nikolasibalic/ZSAR-Zeeman-Shifted-Atomic-Reference/parts/technical_drawings.PDF

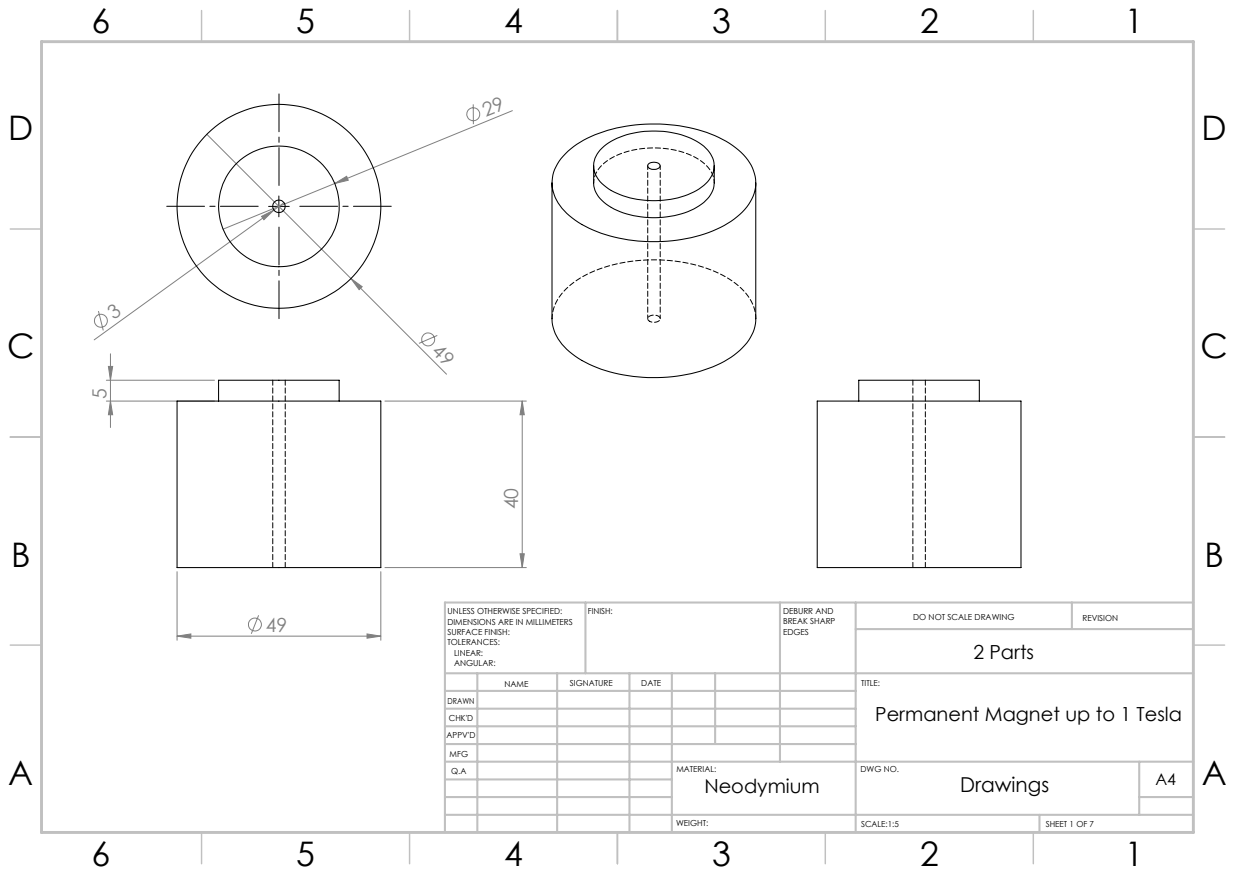
[picture p3: page 1]
2 Parts; FINISH:; DEBURR AND; BREAK SHARP; DO NOT SCALE DRAWING; REVISION; SCALE:1:5; SHEET 1 OF 7

UNLESS OTHERWISE SPECIFIED:
DIMENSIONS ARE IN MILLIMETERS
SURFACE FINISH:
TOLERANCES:
LINEAR:
ANGULAR:

NAME | SIGNATURE | DATE | | | | TITLE: Permanent Magnet up to 1 Tesla

DRAWN
CHK'D
APPV'D
MFG
Q.A | | | | MATERIAL: Neodymium | DWG NO. Drawings | A4

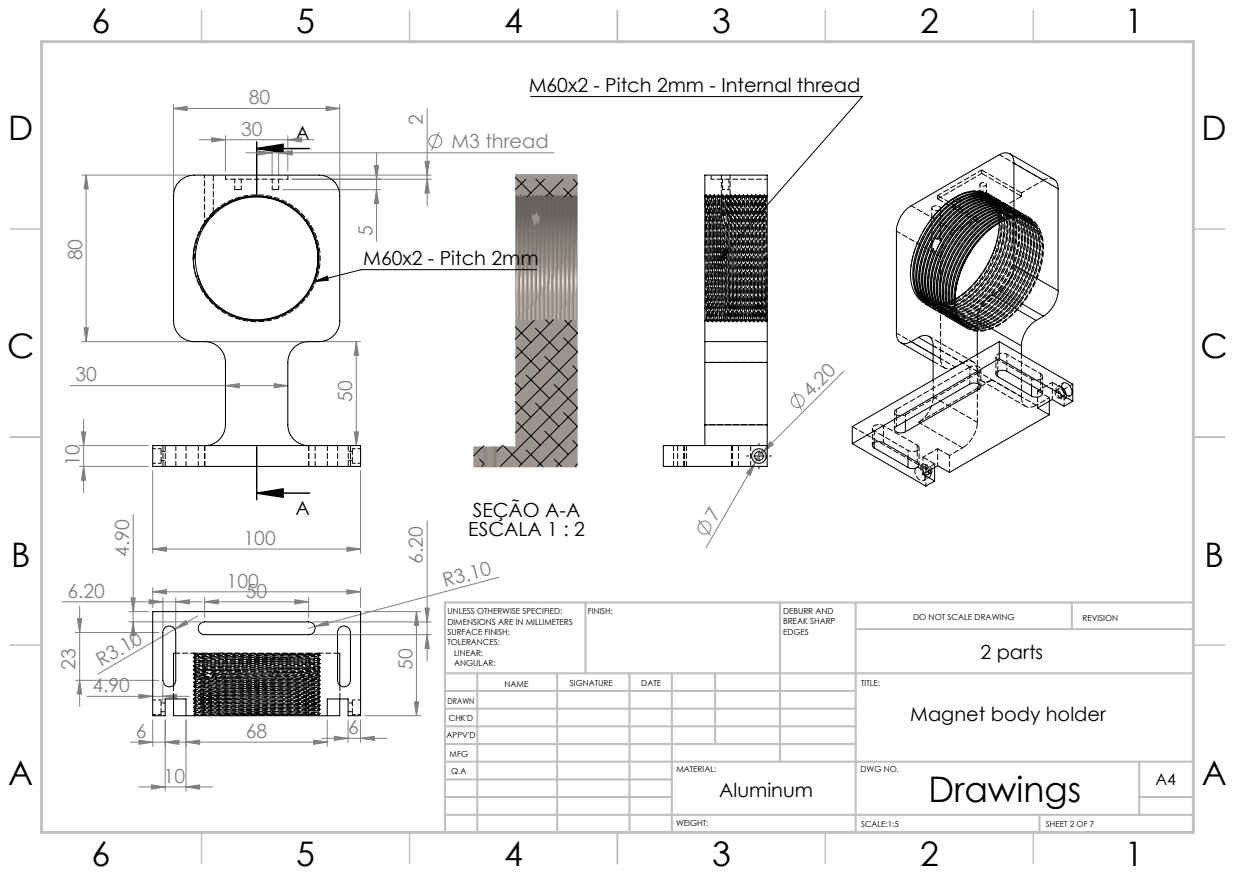
[picture p4: page 2]
M3 thread A; M60x2 - Pitch 2mm; SEÇÃO A-A ESCALA 1 : 2; 2 parts; FINISH:; DEBURR AND; BREAK SHARP; DO NOT SCALE DRAWING; REVISION

M60x2 - Pitch 2mm - Internal thread

UNLESS OTHERWISE SPECIFIED:
DIMENSIONS ARE IN MILLIMETERS
SURFACE FINISH:
TOLERANCES:
LINEAR:
ANGULAR:

NAME | SIGNATURE | DATE | | | | TITLE: Magnet body holder

DRAWN
CHK'D
APPV'D
MFG
Q.A | | | | MATERIAL: Aluminum | DWG NO. Drawings | A4

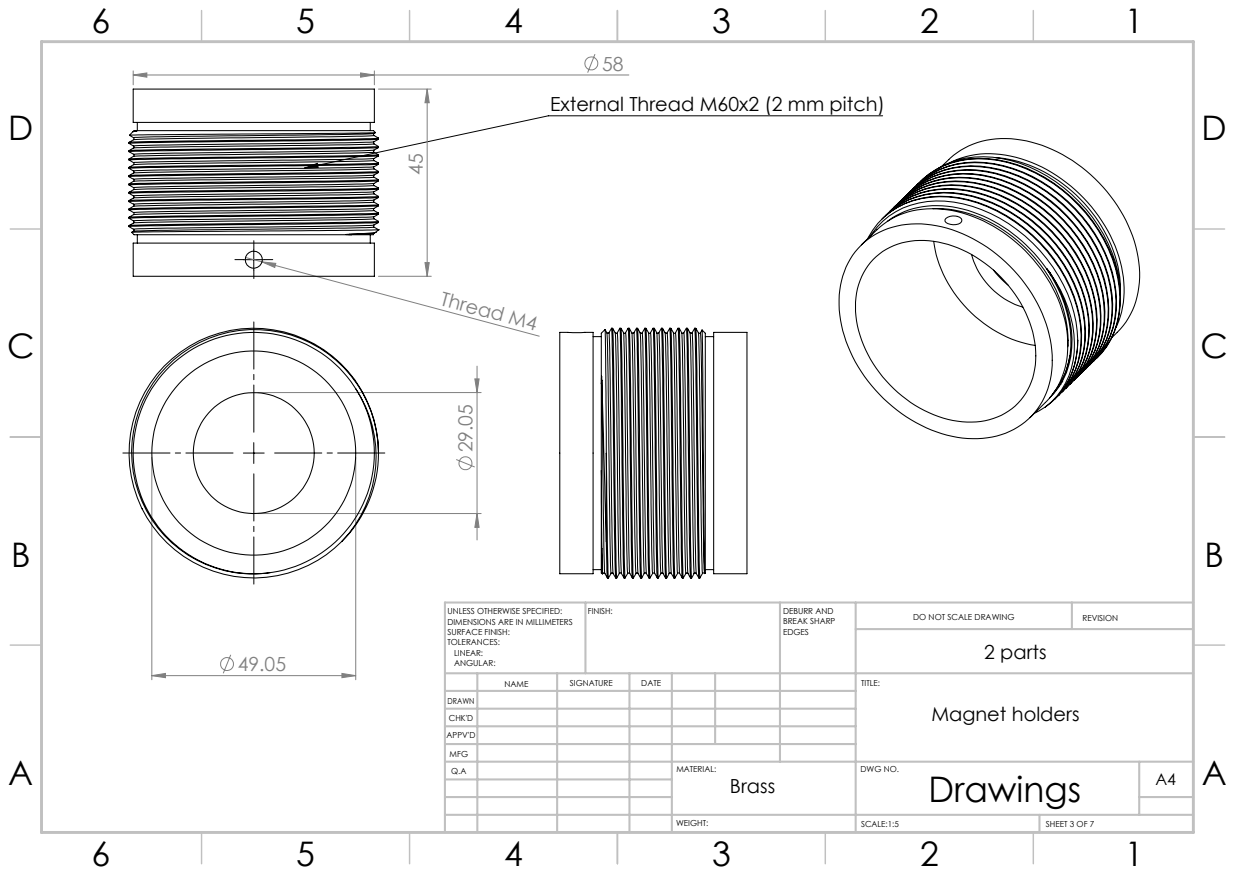
[picture p5: page 3]
Thread M4; 2 parts; FINISH:; DEBURR AND; BREAK SHARP; DO NOT SCALE DRAWING; REVISION

External Thread M60x2 (2 mm pitch)

UNLESS OTHERWISE SPECIFIED:
DIMENSIONS ARE IN MILLIMETERS
SURFACE FINISH:
TOLERANCES:
LINEAR:
ANGULAR:

NAME | SIGNATURE | DATE | | | | TITLE: Magnet holders

DRAWN
CHK'D
APPV'D
MFG
Q.A | | | | MATERIAL: Brass | DWG NO. Drawings | A4

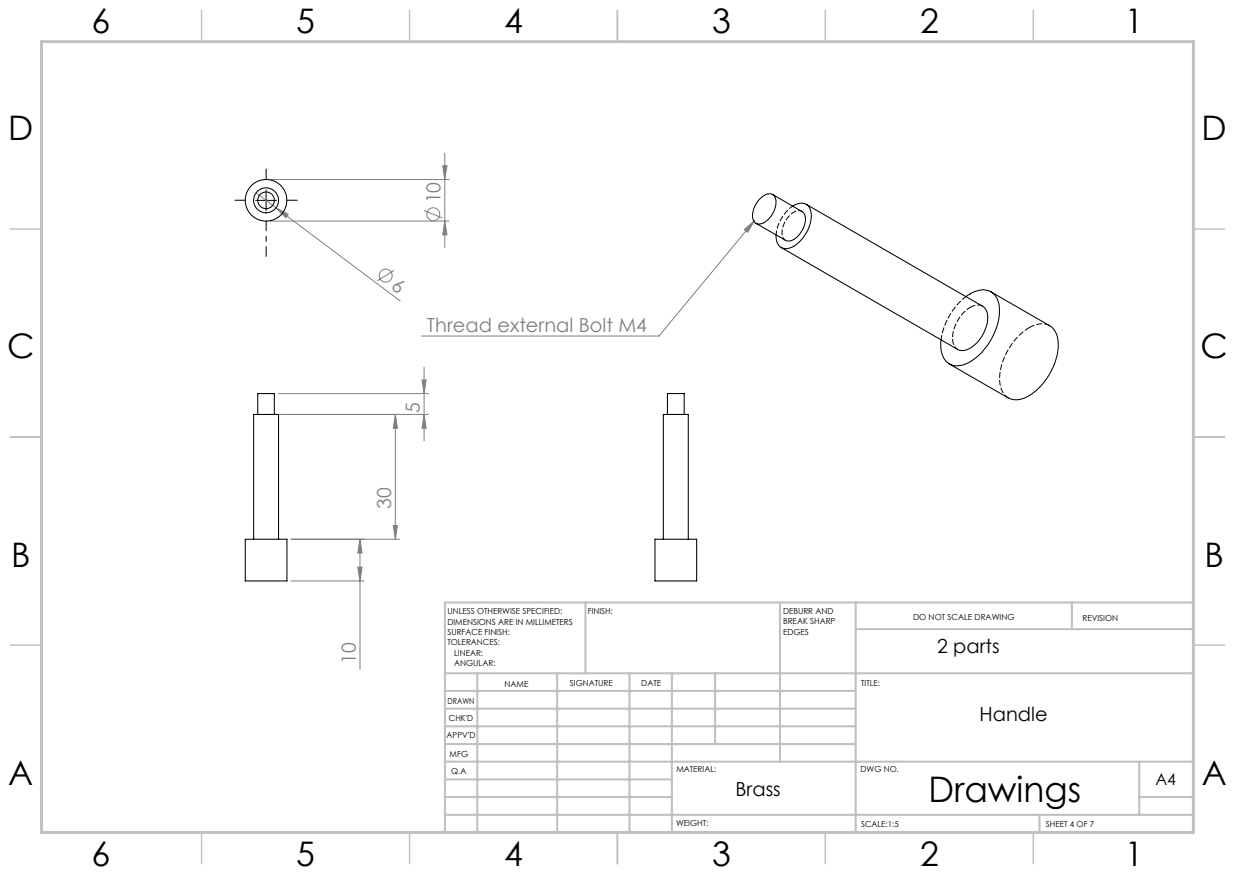
[picture p6: page 4]
2 parts; FINISH:; DEBURR AND; BREAK SHARP; DO NOT SCALE DRAWING; REVISION

Thread external Bolt M4

UNLESS OTHERWISE SPECIFIED:
DIMENSIONS ARE IN MILLIMETERS
SURFACE FINISH:
TOLERANCES:
LINEAR:
ANGULAR:

NAME | SIGNATURE | DATE | | | | TITLE: Handle

DRAWN
CHK'D
APPV'D
MFG
Q.A | | | | MATERIAL: Brass | DWG NO. Drawings | A4

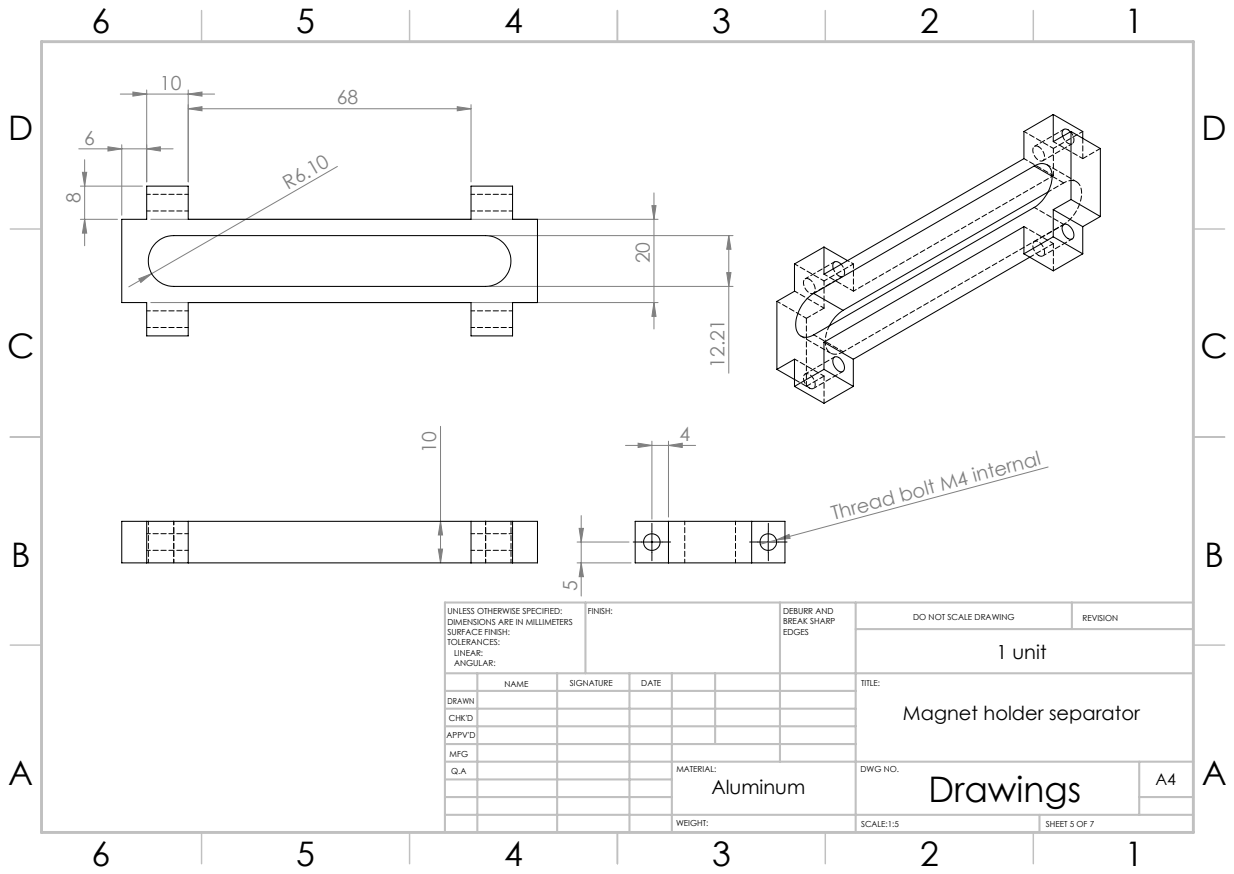
[picture p7: page 5]
1 unit; FINISH:; DEBURR AND; BREAK SHARP; DO NOT SCALE DRAWING; REVISION

Thread bolt M4 internal

UNLESS OTHERWISE SPECIFIED:
DIMENSIONS ARE IN MILLIMETERS
SURFACE FINISH:
TOLERANCES:
LINEAR:
ANGULAR:

NAME | SIGNATURE | DATE | | | | TITLE: Magnet holder separator

DRAWN
CHK'D
APPV'D
MFG
Q.A | | | | MATERIAL: Aluminum | DWG NO. Drawings | A4

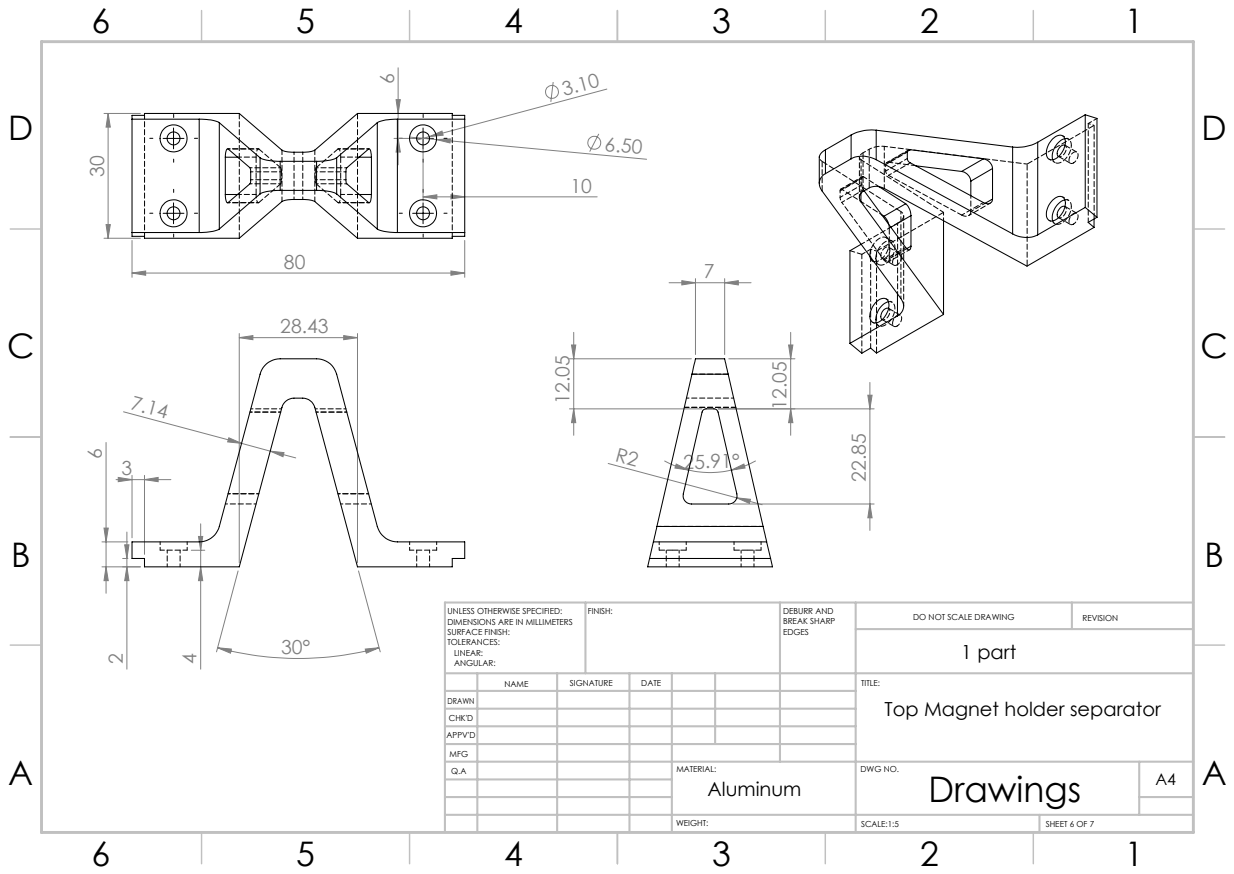
[picture p8: page 6]
1 part; FINISH:; DEBURR AND; BREAK SHARP; DO NOT SCALE DRAWING; REVISION

UNLESS OTHERWISE SPECIFIED:
DIMENSIONS ARE IN MILLIMETERS
SURFACE FINISH:
TOLERANCES:
LINEAR:
ANGULAR:

NAME | SIGNATURE | DATE | | | | TITLE: Top Magnet holder separator

DRAWN
CHK'D
APPV'D
MFG
Q.A | | | | MATERIAL: Aluminum | DWG NO. Drawings | A4

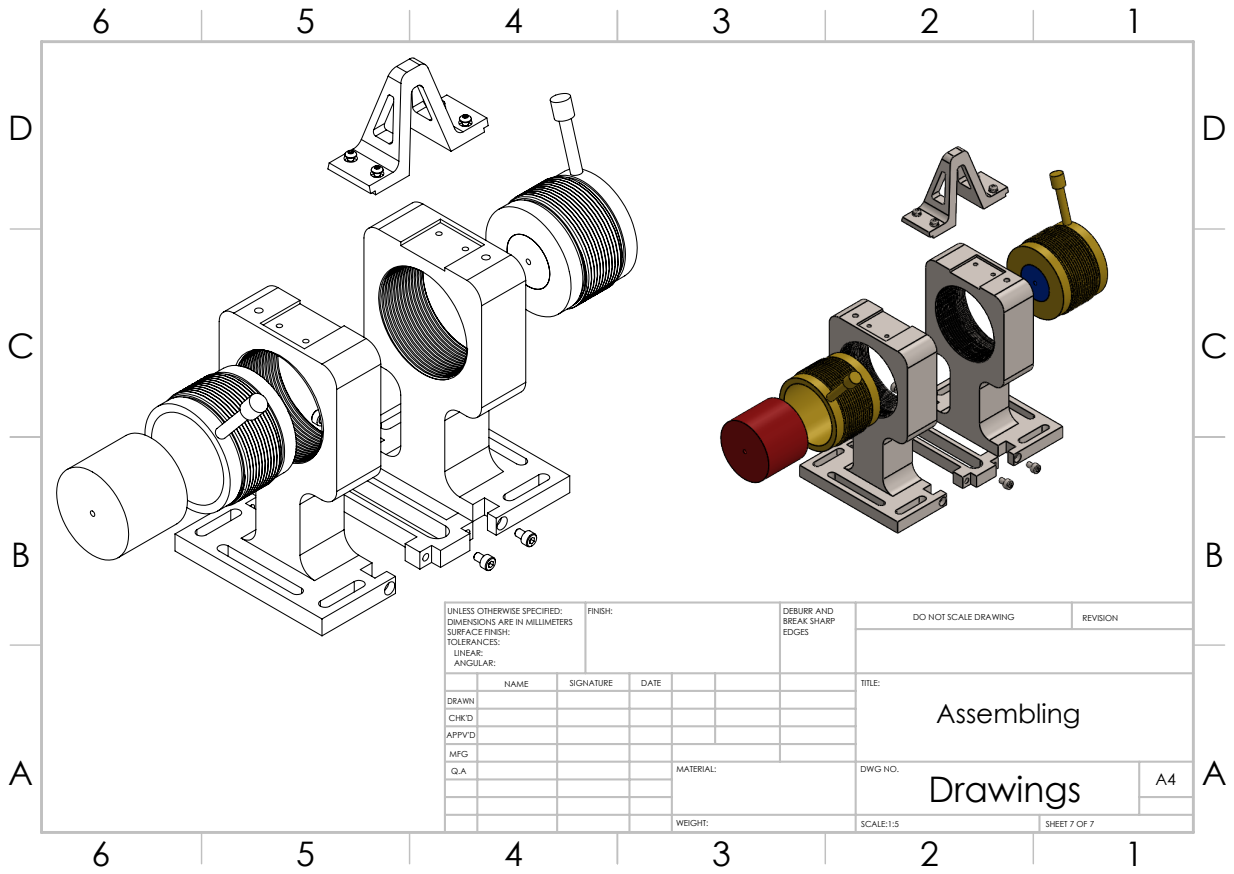
[picture p9: page 7]
FINISH:; DEBURR AND; BREAK SHARP; DO NOT SCALE DRAWING; REVISION

UNLESS OTHERWISE SPECIFIED:
DIMENSIONS ARE IN MILLIMETERS
SURFACE FINISH:
TOLERANCES:
LINEAR:
ANGULAR:

NAME | SIGNATURE | DATE | | | | TITLE: Assembling

DRAWN
CHK'D
APPV'D
MFG
Q.A | | | | MATERIAL: | DWG NO. Drawings | A4
