nikolasibalic/ZSAR-Zeeman-Shifted-Atomic-Reference/parts/magnet_holder.STEP

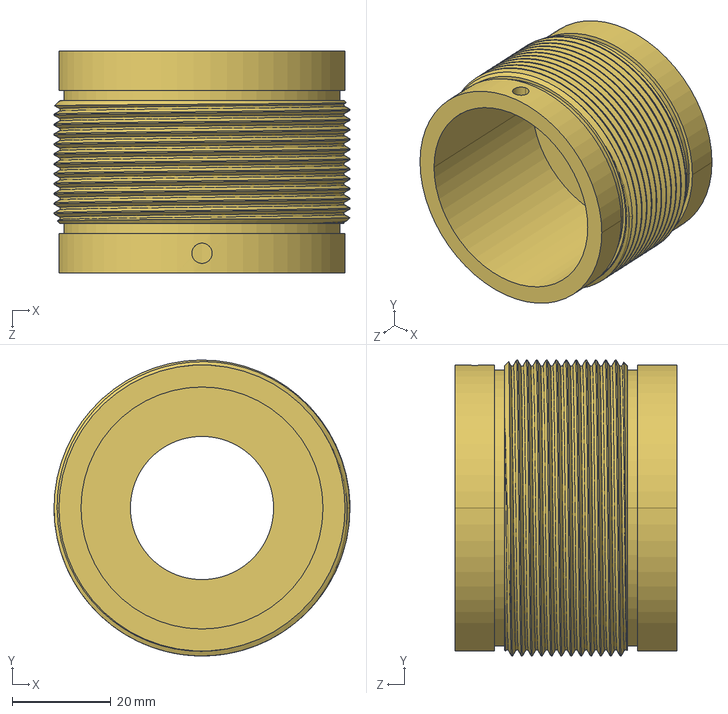
[picture p11: CAD file, 2018-04-18]
parts/magnet_holder.STEP
60.0 x 60.0 x 45.0 mm
