nikolasibalic/ZSAR-Zeeman-Shifted-Atomic-Reference/parts/magnet.STEP

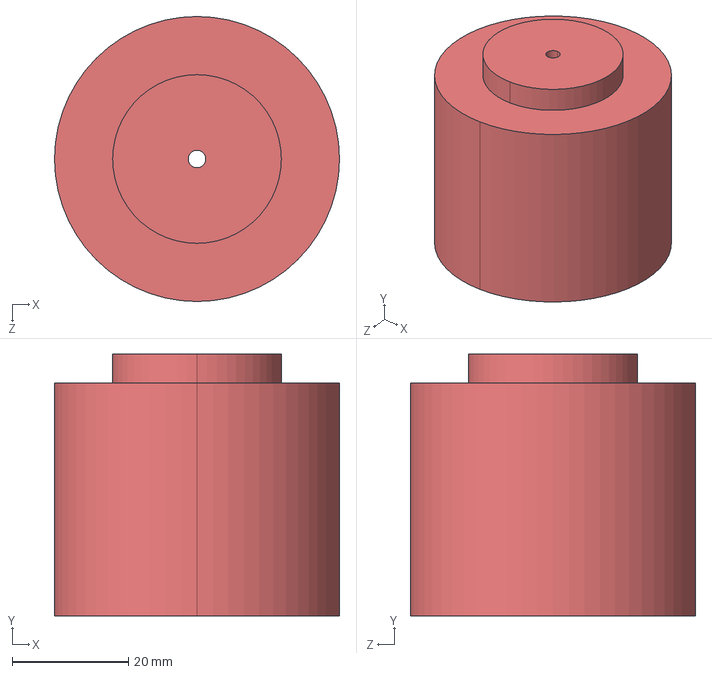
[picture p15: CAD file, 2018-04-18]
parts/magnet.STEP
49.0 x 45.0 x 49.0 mm
