nikolasibalic/ZSAR-Zeeman-Shifted-Atomic-Reference/parts/handle.STEP

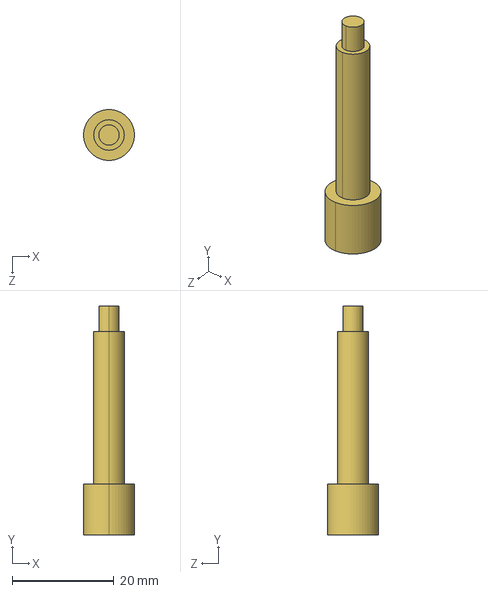
[picture p16: CAD file, 2018-04-18]
parts/handle.STEP
10.0 x 45.0 x 10.0 mm
