nikolasibalic/ZSAR-Zeeman-Shifted-Atomic-Reference/(list of files, cad)

Other CAD files:
parts/handle.STL
parts/magnet.STL
parts/magnet_base_separator.STL
parts/magnet_body_holder.STL
parts/magnet_holder.STL
parts/top_magnet_holder_separator.STL
