nikolasibalic/ZSAR-Zeeman-Shifted-Atomic-Reference/assembly/photo_of_assembly.jpg

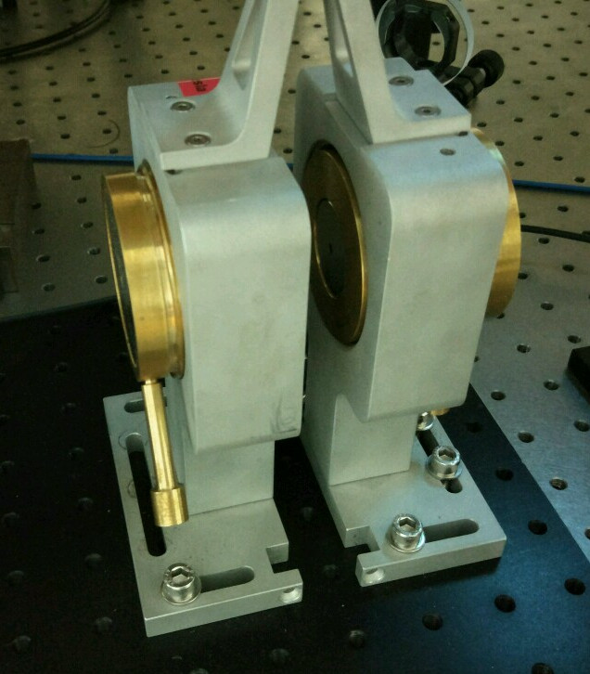
assembly/photo_of_assembly.jpg
